ivanarturo96/IA_robotica_maestria/aruco_marker.pdf

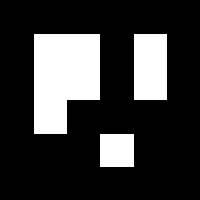
[picture p1: figure]
